amisapta15/adex-neuron-ncs/(commit log)

2026-02-24 Resolve template merge conflicts (take template versions)
    [project.v]
2026-02-26 Remove VGND and VDPWR inputs from tt_um_adex_neuron_ncs
    Removed unused power supply inputs from module.
2026-03-16 added FB_system.gds under ./klayout
    [FB_system.sch, FB_system_bak.sch, V2I_final.sch, V2I_shift_final.sch, neuron_noahp_tb.sch]
2026-03-16 FB_system LVS clean
    [FB_system.sch]
2026-03-16 updated testbench to run simulations with ntap and ptap
    [neuron_noahp_tb.sch]
2026-03-16 before filter-branch
2026-03-16 removed nwell and psub pins from layout. Not necessary
    [FB_system.sch]
2026-03-16 added DPI layout, modified DPI schematic
    [DPI.sch, neuron_noahp.sch]
2026-03-16 progress at DPI layout
    [DPI.sch]
2026-03-16 finished DPI layout. LVS and DRC clean
    [DPI.sch]
2026-03-16 rebasing on main
    [V2I_shift_final.sch, buffer_final.sch]
2026-03-16 updated REF_system to move cap outside. Added Vrefcap pin in the neuron. Added DPI_flat.gds for git check
    [REF_system.sch, buffer_final.sch, inv_lv.sch, neuron_noahp.sch, neuron_noahp_tb.sch, tg1_tb.sch, tg2_tb.sch, tg_lv.sch]
2026-03-16 modified tg_lv.gds and tg_lv.sch, ing_lv.sch to pass LVS
    [inv_lv.sch, tg_lv_bak.sch]
2026-03-16 verified neuron_noahp with V2I and buffer
    [neuron_noahp_tb.sch]
2026-03-17 added neuron_row schematic, added nwell and psub pins to REF_system
    [REF_system.sch, neuron_noahp.sch, neuron_row.sch, untitled.sch]
2026-03-17 verified neuron_row schematic, uploaded a top gds for check
    [chip_top.sch, inv.sch, mux21.sch, mux_tb.sch, neuron_noahp.sch, neuron_noahp_tb.sch, neuron_row_tb.sch, tg_lv.sch]
2026-03-17 started building the chip_top schematic, added stdcell folder for fast reference
    [V2I_shift_final.sch, buffer_final.sch, chip_top.sch, neuron_row.sch]
2026-03-18 finished chip_top schematic, done schematics and symbols for tiehi and tielo stdcell, corrected V2I layout
    [chip_top.sch, sg13g2_tiehi.sch, sg13g2_tielo.sch]
2026-03-18 modified chip_top schematic and ran simulations
    [V2I.sch, analog_buffer.sch, chip_top.sch, chip_top_tb.sch, inv.sch, neuron_noahp.sch, neuron_row.sch, neuron_row_tb.sch]
2026-03-18 switching to hierarchical layout for chip_top and neuron_row
    [neuron_row.sch]
2026-03-19 neuron_noahp.gds DRC and LVS clean.
    [REF_system.sch, inv.sch, neuron_noahp.sch]
2026-03-19 connected power on chip_top
2026-03-19 added decap for analog biases. Pushed to check
    [chip_top.sch]
2026-03-20 finished connections. Before LVS
    [chip_top.sch]
2026-03-20 fixed a few LVS problems.. more to go. Deleted all the ntap/ptap resistors in the schematic
    [DPI.sch, FB_system.sch, REF_system.sch, V2I.sch, analog_buffer.sch, chip_top.sch, inv.sch]
2026-03-20 removed all nwell and psub pins. LVS clean except for decaps
    [DPI.sch, FB_system.sch, REF_system.sch, V2I.sch, analog_buffer.sch, chip_top.sch, inv.sch, neuron_noahp.sch]
2026-03-20 changing the way caps are arranged in schematic
    [chip_top.sch]
2026-03-20 LVS clean. Pushing to check
    [chip_top.sch, chip_top_tb.sch]
